elnhege/core/Bill of Materials/core-bom-v021.xlsx

LAST UPDATED |  | 2013-08-03
SPARK CORE
Qty | Device | Minimum Specification | Component Value (if different) | Package/Case | Designator | AVL | AVL P/N | Additional Comments
1 | Fab PCB | FR4, 1.6mm, 1OZ, Electroless Nickel Immersion Gold, White Solder Mask, Black Silkscreen
7 | Ceramic Capacitor | 100nF, Ceramic, 10V, 10%, X5R | 25V, X7R | 0603 | C4, C7-8, C13-15, C17 | Yageo | CC0603KRX7R8BB104
4 | Ceramic Capacitor | 22pF, Ceramic, 10V, 10%, X5R | 50V, 5% | 0603 | C9,C10, C11, C12 | Yageo | CC0603JRNPO9BN220
2 | Ceramic Capacitor | 4.7uF, Ceramic, 10V, 10%, X5R |  | 0603 | C1, C2 | Taiyo Yuden | LMK107BJ475KAHT
1 | Chip Resistor Array | 1K, 1/4W, 4 Resistors, 5% | 62.5mW per element | 1206 | RN1 | Panasonic Electric Components | EXB-38V102JV
1 | Crystal | 8MHz Crystal, 18pF, SMD |  | 5032 | Y2 | Song Ji | SMD5032 4P 30M | 4 pads
1 | Diode | 20V, 500mA |  | SOD-323 | D1 | Micro Commercial Co | RB551V-30-TP
1 | Dual NPN transistor | Dual NPN, 40V |  | SOT363 | Q1 | Micro Commercial Co | MMDT3904-TP
1 | Ferrite bead | 220Ω, 500mA |  | 0603 | L2 | Murata | BLM18AG221SN1D
2 | Header | Single String, 0.230" Mating Length |  | 0.1", 12 pin | JP1, JP2 | Kaweei | CP25411-12G-S116-A
1 | LED | Blue, SMD |  | 0603 | LED1 | Wenliang | WLUB0603A-341
1 | Microcontroller | MCU ARM 128K, 48-pin |  | LQFP48 | U3 | STMicroelectronics | STM32F103CBT6
2 | Resistor | 10K, 1/10W, 5% |  | 0603 | R1, R8 | Yageo | RC0603JR-0710KL
2 | Resistor | 22Ω, 1/10W, 5% |  | 0603 | R5, R6 | Yageo | RC0603JR-0722RL
2 | Resistor | 1K, 1/10W, 5% |  | 0603 | R4, R9 | Yageo | RC0603JR-071KL
1 | Resistor | 33K, 1/10W, 5% |  | 0603 | R2 | Yageo | RC0603JR-0733KL
1 | Resistor | 1K5, 1/10W, 5% |  | 0603 | R3 | Yageo | RC0603JR-071K5L
1 | Resistor | 47K, 1/10W, 5% |  | 0603 | R7 | Yageo | RC0603JR-0747KL
1 | RGB LED | 3528 RGB LED |  | 3528 | LED2 | Wenliang | WLRGB3528C/R
1 | RTC Crystal | 32.768KHz, 12.5pF RTC Crystal |  | 2-SMD | Y1 | Song Ji | SJFC1332K12P20
1 | SPI Flash Module | 16Mbit, 75MHz |  | 8-SOIC | U4 | Microchip Technology | SST25VF016B-75-4I-S2AF-T
2 | Tactile Switch | Button, 160gf |  | 3.6mm x 3.1mm | B1, B2 | Haoyu | TS-1185A-C
1 | Tantalum Capacitor | 10uF, Tantalum, 10V, 20% | 10% | 1206 | C16 | AVX | TAJA106K010RNJ
1 | USB Micro B Connector | USB Micro B, SMT with TH Board Guides |  | USB-MICROB | X1 | Kaweei | CMCUSB-5BFM2G-01-D
1 | Voltage Regulator | 3.3V, 0.5A LDO |  | SOT223 | U1 | Microchip Technology | MCP1825S-3302E/DB
1 | Wi-Fi Module | Wi-Fi Module |  |  | U2 | Texas Instruments | CC3000MOD
CORE - CA
1 | Chip Antenna | 2.4GHz, Ceramic |  | 8mm x 1mm | A1 | ACX | US PN = 2500AT44M0400E Asia PN = AT8010-E2R9HAA
1 | Ceramic RF Capacitor | 10pF, Ceramic, 25V, 5% | 250V | 0603 | C5, C6 | Johanson Technology Inc | 251R14S100JV4T | Must be RF capacitor
1 | Ceramic RF Capacitor | 2.2pF, Ceramic, 25V, ±0.25pF | 250V, ±0.1pF | 0603 | C3 | Johanson Technology Inc | 251R14S2R2BV4T | Must be RF capacitor
1 | RF Inductor | 2.2nH, Ceramic |  | 0603 | L1 | TDK | MLG1608B2N2S | Must be RF inductor
CORE - UFL
1 | Ceramic RF Capacitor | 10pF, Ceramic, 25V, 5% | 250V | 0603 | C5, C6 | Johanson Technology Inc | 251R14S100JV4T | Must be RF capacitor
1 | uFL Connector | IPEX-20279-001E |  | SMD | X2 | Kaweei | P1163-0140R
ACCESSORIES
Qty | Device | Minimum Specification | Component Value (if different) | Package/Case | Designator | AVL | AVL P/N | Additional Comments
1 | Mini Breadboard | Transparent, 400pt or smaller |  | 3.5 x 4.5cm
1 | USB Micro - B Cable | 0.5m Flat, White |  | USB-MICROB
PACKAGING
Qty | Device | Minimum Specification | Component Value (if different) | Package/Case | Designator | AVL | AVL P/N | Additional Comments
1 | Core Box | 1-C Printed Cardboard, White on Craft
1 | Static Sponge
1 | Cardboard Insert | Plain cardboard, no printing
