elnhege/core/EAGLE/core.brd

## EAGLE design EAGLE/core.brd (2013-08-07)

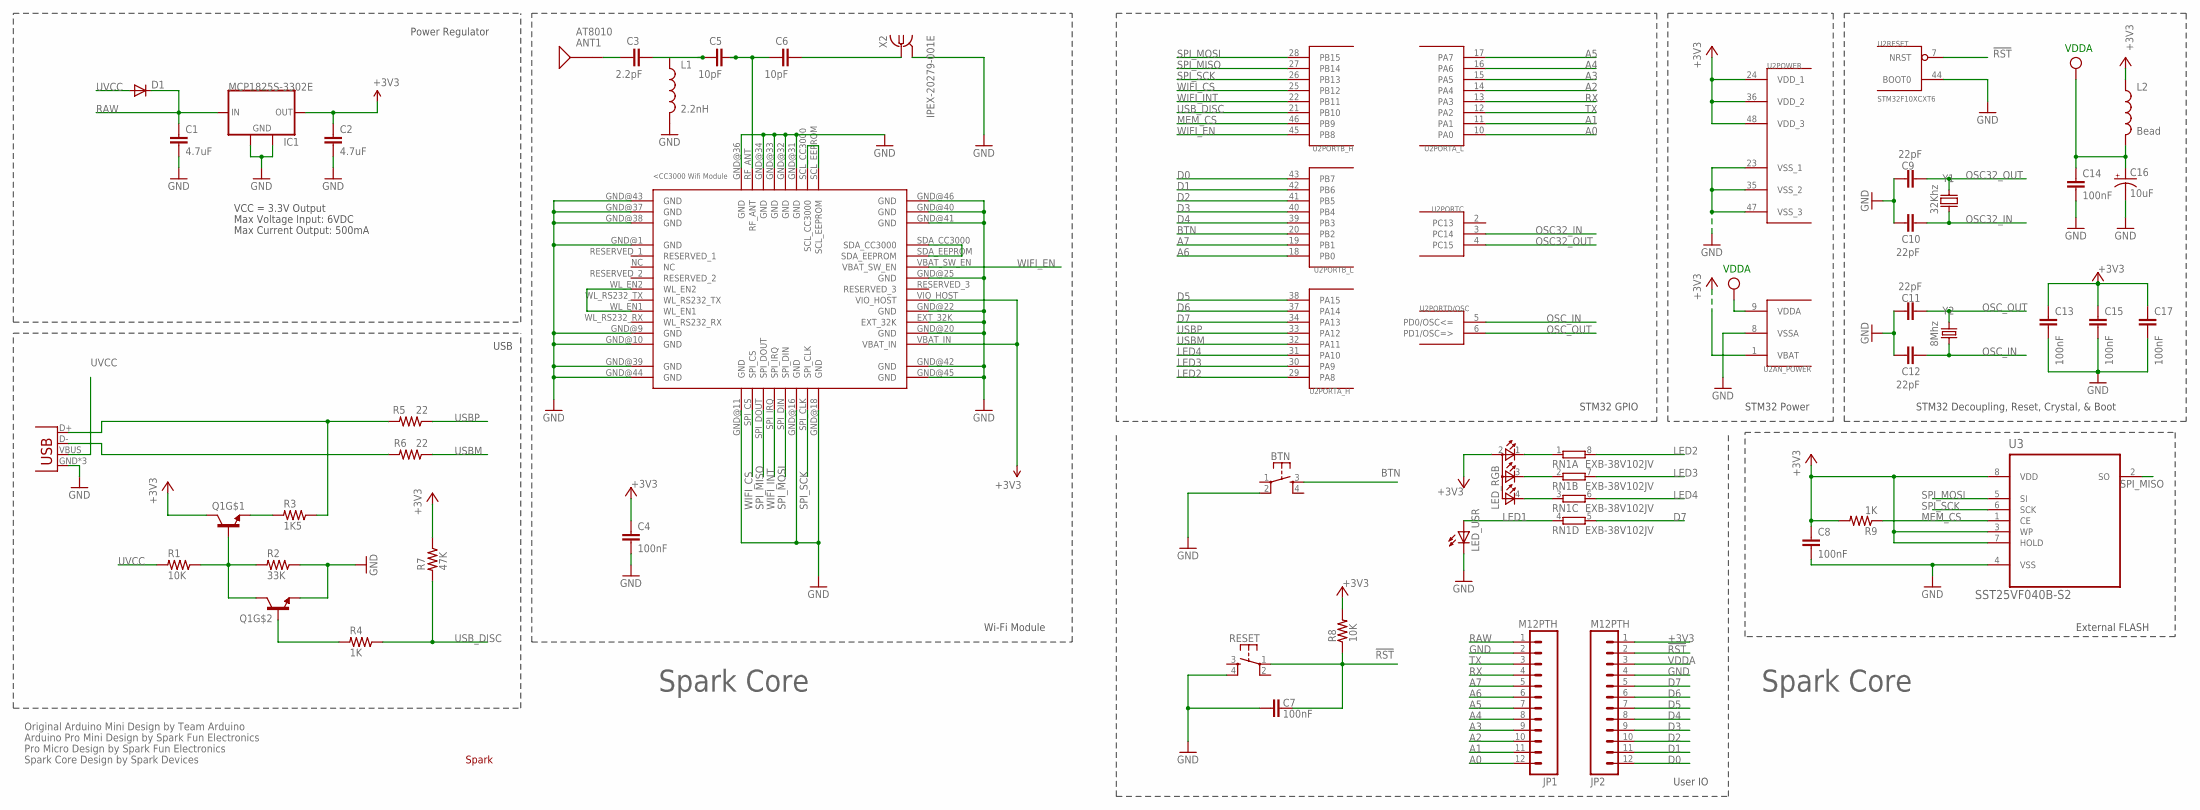
[picture p1: schematic core.sch]

Parts:
ANT1: AT8010
BTN: KMR211GLFS; TACTILE_SWITCH_SMD
C1, C2: 4.7uF; C0603
C3: 2.2pF; C0603
C4, C7, C8, C13, C14, C15, C17: 100nF; C0603
C5, C6: 10pF; C0603
C9, C10, C11, C12: 22pF; C0603
C16: 10uF; EIA3216
D1: DIODESOD; SOD-323
IC1: MCP1825S-3302E; SOT223
JP1, JP2: M12PTH; 1X12-SMALL-PADS
L1: 2.2nH; 0603
L2: Bead; 0603
LED_RGB: TOPLED-3PLCC; P-LCC-4-3
LED_USR: LED0603; LED-0603
Q1: MMDT3904; SOT363
R1, R8: 10K; R0603
R2: 33K; R0603
R3: 1K5; R0603
R4, R9: 1K; R0603
R5, R6: 22; R0603
R7: 47K; R0603
RESET: KMR211GLFS; TACTILE_SWITCH_SMD
RN1: EXB-38V102JV; EXB38V
U1: CC3000
U2: STM32F10XCXT6; TQFP48
U3: SST25VF040B-S2; SOIC127P790X216-8N
U$1: SPARK_LOGO2
X1: USB-MICROB; USB-MICROB-SLOT-HOLE
X2: IPEX-20279-001E
Y1: 32Khz; FC135
Y2: 8Mhz; CRYSTAL-SMD-5X3

Connections:
!RST: C7.2, JP2.2, R8.1, RESET.1, U2.7 (NRST)
+3V3: C2.1, C4.1, C8.1, C13.1, C15.1, C17.1, IC1.3 (OUT), JP2.1, L2.1, LED_RGB.2 (A2), Q1.3 (C), R7.1, R8.2, R9.2, U1.VBAT_IN, U1.VIO_HOST, U2.1 (VBAT), U2.24 (VDD_1), U2.36 (VDD_2), U2.48 (VDD_3), U3.3 (WP), U3.7 (HOLD), U3.8 (VDD)
A0: JP1.12, U2.10 (PA0)
A1: JP1.11, U2.11 (PA1)
A2: JP1.10, U2.14 (PA4)
A3: JP1.9, U2.15 (PA5)
A4: JP1.8, U2.16 (PA6)
A5: JP1.7, U2.17 (PA7)
A6: JP1.6, U2.18 (PB0)
A7: JP1.5, U2.19 (PB1)
BTN: BTN.3, U2.20 (PB2)
D0: JP2.12, U2.43 (PB7)
D1: JP2.11, U2.42 (PB6)
D2: JP2.10, U2.41 (PB5)
D3: JP2.9, U2.40 (PB4)
D4: JP2.8, U2.39 (PB3)
D5: JP2.7, U2.38 (PA15)
D6: JP2.6, U2.37 (PA14)
D7: JP2.5, RN1.5 (2), U2.34 (PA13)
GND: BTN.2, C1.2, C2.2, C4.2, C7.1, C8.2, C9.2, C10.2, C11.2, C12.2, C13.2, C14.2, C15.2, C16.C (-), C17.2, IC1.2 (GND), IC1.4 (GND), JP1.2, JP2.4, L1.2, LED_USR.C, Q1.1 (E), R2.1, RESET.4, U1.EXT_32K, U1.GND@1 (GND), U1.GND@9 (GND), U1.GND@10 (GND), U1.GND@11 (GND), U1.GND@16 (GND), U1.GND@18 (GND), U1.GND@20 (GND), U1.GND@22 (GND), U1.GND@25 (GND), U1.GND@31 (GND), U1.GND@32 (GND), U1.GND@33 (GND), U1.GND@34 (GND), U1.GND@36 (GND), U1.GND@37 (GND), U1.GND@38 (GND), U1.GND@39 (GND), U1.GND@40 (GND), U1.GND@41 (GND), U1.GND@42 (GND), U1.GND@43 (GND), U1.GND@44 (GND), U1.GND@45 (GND), U1.GND@46 (GND), U2.8 (VSSA), U2.23 (VSS_1), U2.35 (VSS_2), U2.44 (BOOT0), U2.47 (VSS_3), U3.4 (VSS), X1.GND, X1.MT1 (GND), X1.MT2 (GND), X2.2@1 (GND), X2.2@2 (GND)
LED1: LED_USR.A, RN1.4 (1)
LED2: RN1.8 (2), U2.29 (PA8)
LED3: RN1.7 (2), U2.30 (PA9)
LED4: RN1.6 (2), U2.31 (PA10)
MEM_CS: R9.1, U2.46 (PB9), U3.1 (CE)
unnamed: R3.1, R5.2, X1.D+
unnamed: C6.2, X2.1
unnamed: ANT1.SIG, C3.1
unnamed: C5.2, C6.1, U1.RF_ANT
unnamed: C3.2, C5.1, L1.1
unnamed: R6.2, X1.D-
unnamed: U1.SCL_CC3000, U1.SCL_EEPROM
unnamed: Q1.2 (B), R4.2
unnamed: U1.WL_EN1, U1.WL_EN2
unnamed: LED_RGB.1 (CRED), RN1.1
unnamed: LED_RGB.3 (CBLUE), RN1.2 (1)
unnamed: Q1.5 (B), Q1.6 (C), R1.1, R2.2
unnamed: LED_RGB.4 (CGREEN), RN1.3 (1)
unnamed: U1.SDA_CC3000, U1.SDA_EEPROM
unnamed: Q1.4 (E), R3.2
OSC32_IN: C10.1, U2.3 (PC14), Y1.X1 (1)
OSC32_OUT: C9.1, U2.4 (PC15), Y1.X2 (2)
OSC_IN: C12.1, U2.5 (PD0/OSC<=), Y2.1
OSC_OUT: C11.1, U2.6 (PD1/OSC=>), Y2.3 (2)
RAW: C1.1, D1.1 (C), IC1.1 (IN), JP1.1
RX: JP1.4, U2.13 (PA3)
SPI_MISO: U1.SPI_DOUT, U2.27 (PB14), U3.2 (SO)
SPI_MOSI: U1.SPI_DIN, U2.28 (PB15), U3.5 (SI)
SPI_SCK: U1.SPI_CLK, U2.26 (PB13), U3.6 (SCK)
TX: JP1.3, U2.12 (PA2)
USBM: R6.1, U2.32 (PA11)
USBP: R5.1, U2.33 (PA12)
USB_DISC: R4.1, R7.2, U2.21 (PB10)
UVCC: D1.2 (A), R1.2, X1.VBUS
VDDA: C14.1, C16.A (+), JP2.3, L2.2, U2.9 (VDDA)
WIFI_CS: U1.SPI_CS, U2.25 (PB12)
WIFI_EN: U1.VBAT_SW_EN, U2.45 (PB8)
WIFI_INT: U1.SPI_IRQ, U2.22 (PB11)

Notes on the sheet:
Original Arduino Mini Design by Team Arduino
Arduino Pro Mini Design by Spark Fun Electronics
Max Voltage Input: 6VDC
Max Current Output: 500mA
Power Regulator
VCC = 3.3V Output
Pro Micro Design by Spark Fun Electronics
Spark Core Design by Spark Devices
STM32 Decoupling, Reset, Crystal, & Boot
STM32 GPIO
STM32 Power
External FLASH
User IO
USB
Spark Core
Wi-Fi Module
VDDA

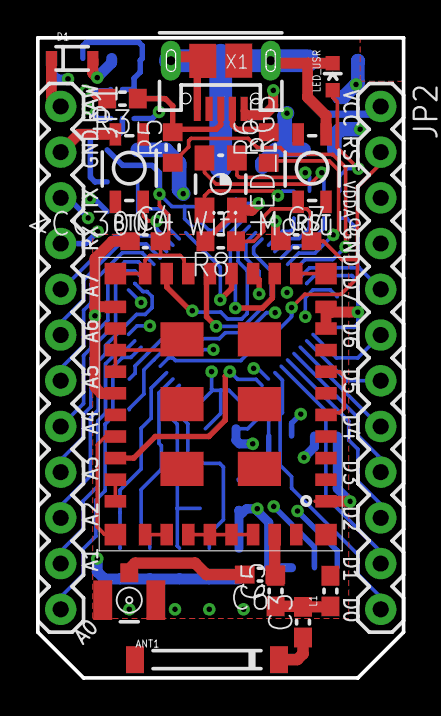
[picture p2: board core.brd from above]

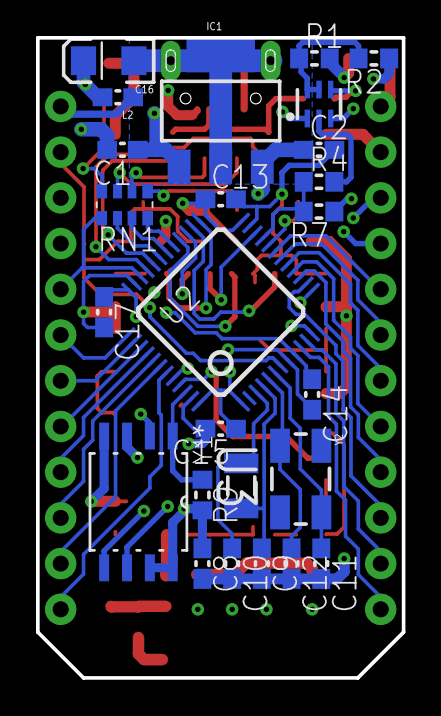
[picture p3: board core.brd from below]

Board: 4 copper layers, 20.3 x 35.6 mm, 47 parts (25 on the bottom side), 58 nets.
