elnhege/core/(commit log)

2013-08-05 Shifted Core board up and created mounting files
    [core.brd]
2013-08-06 Fixed RGB LED Silkscreen
    [core.brd, core.sch]
2013-08-07 added DIODE lib
2013-08-07 updated diode footprint
